Through-interference/through-interference/tests/Screenshot From 2026-10-16 19-52-49.png

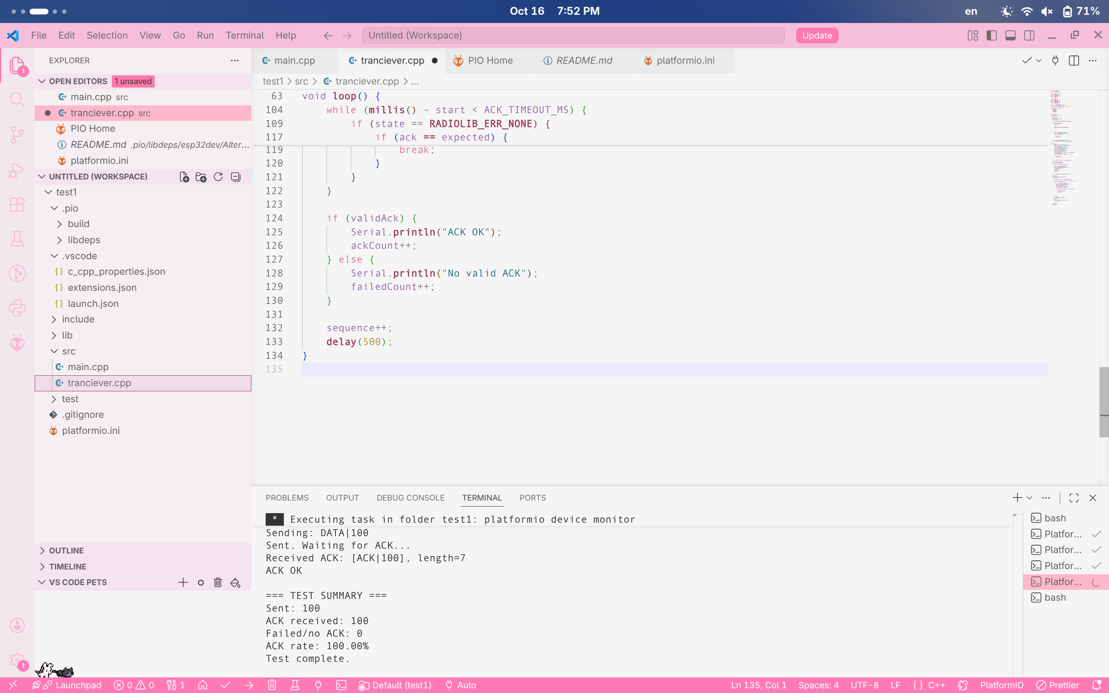
tests/Screenshot From 2026-10-16 19-52-49.png
