Through-interference/through-interference/(commit log)

2026-10-10 Добавил файлы
2026-11-08 Implement bidirectional CAN telemetry with USB acknowledgments and reboot-safe radio sessions
    [AtCommandManager.cpp, AtCommandManager.h, BridgeController.cpp, BridgeController.h, CanHardware.cpp, CanHardware.h, CanProtocol.cpp, CanProtocol.h]
2026-11-08 Add separate ground and air consoles for two computers
2026-11-08 Add Linux ground launcher and onboard CAN diagnostics
2026-11-12 Fix UART reconnects and radio/CAN recovery
    [BridgeController.cpp, BridgeController.h, bridge_recovery_test.cpp, can_client.py, gcs_panel.py, serial_lines.py]
